eilmi/HAMEG-HM1007-serial-interface/MatLab/HM1007_export-2021_02_25-07_37_34/HM1007_plot-2021_02_25-07_37_34.png

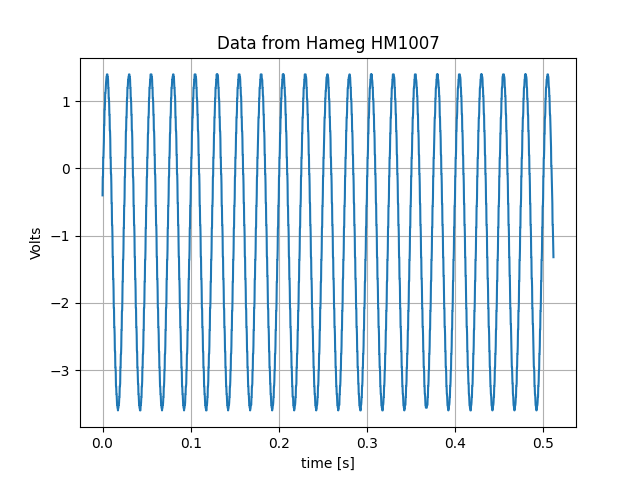
MatLab/HM1007_export-2021_02_25-07_37_34/HM1007_plot-2021_02_25-07_37_34.png
