eilmi/HAMEG-HM1007-serial-interface/Pictures/Hameg_Interface_no_cable.png

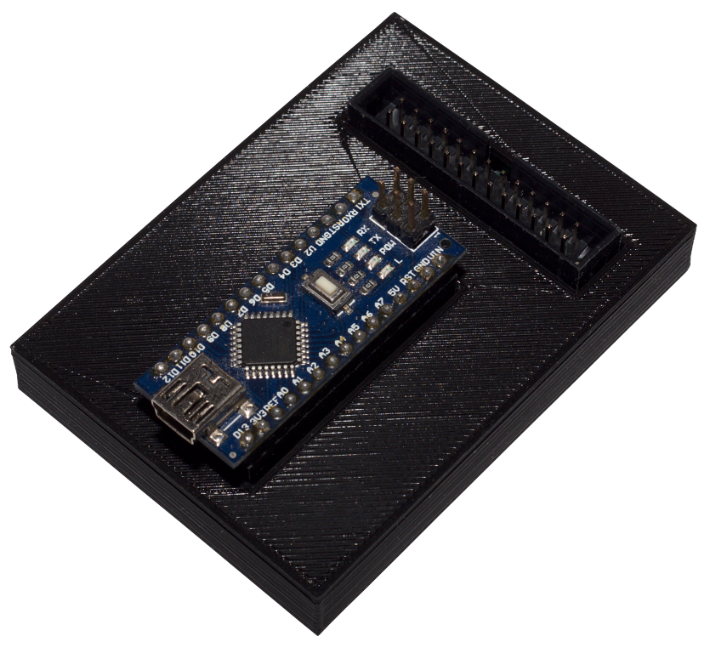
Pictures/Hameg_Interface_no_cable.png
