eilmi/HAMEG-HM1007-serial-interface/Python/testdata/hm1007/4_channels_used/HM1007_data-2022_04_08-07_38_23.csv

time | CH1 | CH2 | REF1 | REF2
0.000000 | 0.320000 | -1.200000 | 0.400000 | -2.200000
0.000000 | 0.400000 | -1.200000 | 0.480000 | -2.200000
0.000000 | 0.400000 | -1.200000 | 0.480000 | -2.200000
0.000001 | 0.400000 | -1.200000 | 0.560000 | -2.200000
0.000001 | 0.400000 | -1.200000 | 0.640000 | -2.000000
0.000001 | 0.480000 | -1.200000 | 0.640000 | -2.000000
0.000002 | 0.480000 | -1.200000 | 0.640000 | -2.000000
0.000002 | 0.560000 | -1.000000 | 0.720000 | -2.000000
0.000002 | 0.560000 | -1.000000 | 0.720000 | -2.000000
0.000002 | 0.560000 | -1.000000 | 0.800000 | -2.000000
0.000002 | 0.560000 | -1.200000 | 0.800000 | -2.000000
0.000003 | 0.640000 | -1.000000 | 0.880000 | -1.800000
0.000003 | 0.640000 | -1.000000 | 0.880000 | -1.800000
0.000003 | 0.640000 | -1.000000 | 0.960000 | -1.800000
0.000003 | 0.640000 | -1.000000 | 0.960000 | -1.800000
0.000004 | 0.720000 | -1.000000 | 0.960000 | -1.800000
0.000004 | 0.720000 | -1.000000 | 1.040000 | -1.800000
0.000004 | 0.720000 | -1.000000 | 1.040000 | -1.800000
0.000005 | 0.720000 | -1.000000 | 1.120000 | -1.800000
0.000005 | 0.800000 | -1.000000 | 1.200000 | -1.600000
0.000005 | 0.800000 | -1.000000 | 1.200000 | -1.600000
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
