eilmi/HAMEG-HM1007-serial-interface/Python/testdata/hm1007/fast_sinus/HM1007_data-2021_02_21-11_49_18.csv

CH1
142
149
149
156
156
159
162
168
168
174
174
176
180
180
181
183
184
185
186
186
187
187
187
186
186
185
182
182
178
178
176
172
172
166
166
163
156
156
150
150
146
139
139
131
131
127
119
119
111
111
107
100
100
93
93
90
84
84
78
78
76
71
71
68
68
66
64
64
63
63
62
63
63
64
64
65
67
67
71
71
72
78
78
83
83
86
92
92
99
99
103
110
110
118
118
122
130
130
138
138
141
149
149
156
156
159
166
166
171
171
174
178
178
182
182
183
185
185
186
186
187
187
187
186
186
185
182
182
178
178
176
172
172
166
166
163
156
156
149
149
146
138
138
131
131
127
119
119
111
111
107
100
100
93
93
90
84
84
78
78
75
72
72
68
68
66
64
64
63
63
62
62
62
64
64
65
67
67
71
71
73
78
78
83
83
86
92
92
100
100
103
110
110
118
118
122
130
130
138
138
142
149
149
156
156
159
165
165
171
171
173
178
178
182
182
183
185
185
187
187
187
187
187
186
186
185
182
182
178
178
176
172
172
166
166
163
157
157
150
150
146
138
138
131
131
127
119
119
111
111
107
100
100
93
93
90
84
84
78
78
75
71
71
68
68
66
64
64
63
63
62
63
63
64
64
65
67
67
71
71
73
77
77
83
83
86
92
92
100
100
103
111
111
118
118
122
130
130
138
138
142
149
149
156
156
159
165
165
171
171
173
178
178
182
182
183
185
185
186
186
187
187
187
186
186
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
