eilmi/HAMEG-HM1007-serial-interface/Python/testdata/hm205-3/hm205-3_both_channels/HM1007_data-2022_05_17-11_46_32.csv

time | CH1 | CH2
0.000000 | 0.160000 | 3.520000
0.000250 | 0.240000 | 3.520000
0.000500 | 0.320000 | 3.520000
0.000750 | 0.400000 | 3.520000
0.001000 | 0.480000 | 3.520000
0.001250 | 0.560000 | 3.520000
0.001500 | 0.640000 | 3.520000
0.001750 | 0.680000 | 3.520000
0.002000 | 0.760000 | 3.520000
0.002250 | 0.800000 | 3.520000
0.002500 | 0.880000 | 3.520000
0.002750 | 0.960000 | 3.520000
0.003000 | 1.040000 | 3.520000
0.003250 | 1.120000 | 3.520000
0.003500 | 1.200000 | 3.520000
0.003750 | 1.280000 | 3.520000
0.004000 | 1.320000 | 3.520000
0.004250 | 1.400000 | 3.520000
0.004500 | 1.480000 | 3.520000
0.004750 | 1.520000 | 3.520000
0.005000 | 1.600000 | 3.520000
0.005250 | 1.640000 | 3.520000
0.005500 | 1.680000 | 3.520000
0.005750 | 1.760000 | 3.520000
0.006000 | 1.840000 | 3.520000
0.006250 | 1.880000 | 3.520000
0.006500 | 1.960000 | 3.520000
0.006750 | 2.000000 | 3.520000
0.007000 | 2.080000 | 3.520000
0.007250 | 2.120000 | 3.520000
0.007500 | 2.160000 | 3.520000
0.007750 | 2.240000 | 3.520000
0.008000 | 2.280000 | 3.520000
0.008250 | 2.320000 | 3.520000
0.008500 | 2.360000 | 3.520000
0.008750 | 2.400000 | 3.520000
0.009000 | 2.440000 | 3.520000
0.009250 | 2.480000 | 3.520000
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
