eilmi/HAMEG-HM1007-serial-interface/Python/testdata/hm205-3/hm205-3_both_CHs_CH2_first/HM1007_data-2022_05_17-11_46_21.csv

time | CH1 | CH2
0.000000 | -0.920000 | 3.520000
0.000250 | -0.920000 | 3.520000
0.000500 | -0.840000 | 3.520000
0.000750 | -0.760000 | 3.520000
0.001000 | -0.680000 | 3.520000
0.001250 | -0.640000 | 3.520000
0.001500 | -0.560000 | 3.520000
0.001750 | -0.480000 | 3.520000
0.002000 | -0.400000 | 3.520000
0.002250 | -0.360000 | 3.520000
0.002500 | -0.280000 | 3.520000
0.002750 | -0.200000 | 3.520000
0.003000 | -0.120000 | 3.520000
0.003250 | -0.040000 | 3.520000
0.003500 | 0.040000 | 3.520000
0.003750 | 0.120000 | 3.520000
0.004000 | 0.160000 | 3.520000
0.004250 | 0.280000 | 3.520000
0.004500 | 0.320000 | 3.520000
0.004750 | 0.400000 | 3.520000
0.005000 | 0.480000 | 3.520000
0.005250 | 0.560000 | 3.520000
0.005500 | 0.640000 | 3.520000
0.005750 | 0.720000 | 3.520000
0.006000 | 0.760000 | 3.520000
0.006250 | 0.840000 | 3.520000
0.006500 | 0.920000 | 3.520000
0.006750 | 0.960000 | 3.520000
0.007000 | 1.040000 | 3.520000
0.007250 | 1.120000 | 3.520000
0.007500 | 1.200000 | 3.520000
0.007750 | 1.280000 | 3.520000
0.008000 | 1.320000 | 3.520000
0.008250 | 1.400000 | 3.520000
0.008500 | 1.480000 | 3.520000
0.008750 | 1.520000 | 3.520000
0.009000 | 1.600000 | 3.520000
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
