eilmi/HAMEG-HM1007-serial-interface/Python/testdata/hm205-3/hm205-3_ch1/HM1007_data-2022_05_17-11_54_51.csv

time | CH1
0.000000 | 0.240000
0.000250 | 0.320000
0.000500 | 0.400000
0.000750 | 0.480000
0.001000 | 0.560000
0.001250 | 0.640000
0.001500 | 0.720000
0.001750 | 0.760000
0.002000 | 0.840000
0.002250 | 0.920000
0.002500 | 1.000000
0.002750 | 1.040000
0.003000 | 1.120000
0.003250 | 1.200000
0.003500 | 1.280000
0.003750 | 1.320000
0.004000 | 1.400000
0.004250 | 1.480000
0.004500 | 1.520000
0.004750 | 1.600000
0.005000 | 1.640000
0.005250 | 1.720000
0.005500 | 1.760000
0.005750 | 1.840000
0.006000 | 1.880000
0.006250 | 1.960000
0.006500 | 2.040000
0.006750 | 2.080000
0.007000 | 2.160000
0.007250 | 2.200000
0.007500 | 2.240000
0.007750 | 2.280000
0.008000 | 2.320000
0.008250 | 2.400000
0.008500 | 2.440000
0.008750 | 2.480000
0.009000 | 2.520000
0.009250 | 2.560000
0.009500 | 2.600000
0.009750 | 2.640000
0.010000 | 2.680000
0.010250 | 2.720000
0.010500 | 2.720000
0.010750 | 2.800000
0.011000 | 2.800000
0.011250 | 2.840000
0.011500 | 2.840000
0.011750 | 2.880000
0.012000 | 2.920000
0.012250 | 2.920000
0.012500 | 2.960000
0.012750 | 2.960000
0.013000 | 2.960000
0.013250 | 3.000000
0.013500 | 3.000000
0.013750 | 3.000000
0.014000 | 3.040000
0.014250 | 3.040000
0.014500 | 3.040000
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
