eilmi/HAMEG-HM1007-serial-interface/Python/testdata/hm205-3/hm205-3_only_CH2/HM1007_data-2022_05_17-11_46_53.csv

time | CH2
0.000000 | 3.520000
0.000250 | 3.520000
0.000500 | 3.520000
0.000750 | 3.520000
0.001000 | 3.520000
0.001250 | 3.520000
0.001500 | 3.520000
0.001750 | 3.520000
0.002000 | 3.520000
0.002250 | 3.520000
0.002500 | 3.520000
0.002750 | 3.520000
0.003000 | 3.520000
0.003250 | 3.520000
0.003500 | 3.520000
0.003750 | 3.520000
0.004000 | 3.520000
0.004250 | 3.520000
0.004500 | 3.520000
0.004750 | 3.520000
0.005000 | 3.520000
0.005250 | 3.520000
0.005500 | 3.520000
0.005750 | 3.520000
0.006000 | 3.520000
0.006250 | 3.520000
0.006500 | 3.520000
0.006750 | 3.520000
0.007000 | 3.520000
0.007250 | 3.520000
0.007500 | 3.520000
0.007750 | 3.520000
0.008000 | 3.520000
0.008250 | 3.520000
0.008500 | 3.520000
0.008750 | 3.520000
0.009000 | 3.520000
0.009250 | 3.520000
0.009500 | 3.520000
0.009750 | 3.520000
0.010000 | 3.520000
0.010250 | 3.520000
0.010500 | 3.520000
0.010750 | 3.520000
0.011000 | 3.520000
0.011250 | 3.520000
0.011500 | 3.520000
0.011750 | 3.520000
0.012000 | 3.520000
0.012250 | 3.520000
0.012500 | 3.520000
0.012750 | 3.520000
0.013000 | 3.520000
0.013250 | 3.520000
0.013500 | 3.520000
0.013750 | 3.520000
0.014000 | 3.520000
0.014250 | 3.520000
0.014500 | 3.520000
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
