eilmi/HAMEG-HM1007-serial-interface/Python/testdata/hm205-3/hm205-3_both_channels/HM1007_plot-2022_05_17-11_46_32.png

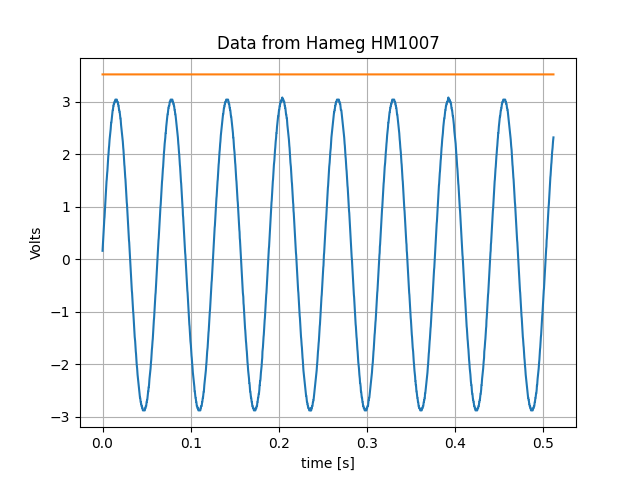
Python/testdata/hm205-3/hm205-3_both_channels/HM1007_plot-2022_05_17-11_46_32.png
