eilmi/HAMEG-HM1007-serial-interface/Python/testdata/hm205-3/hm205-3_both_chs_CH1_first/HM1007_plot-2022_05_17-11_46_19.png

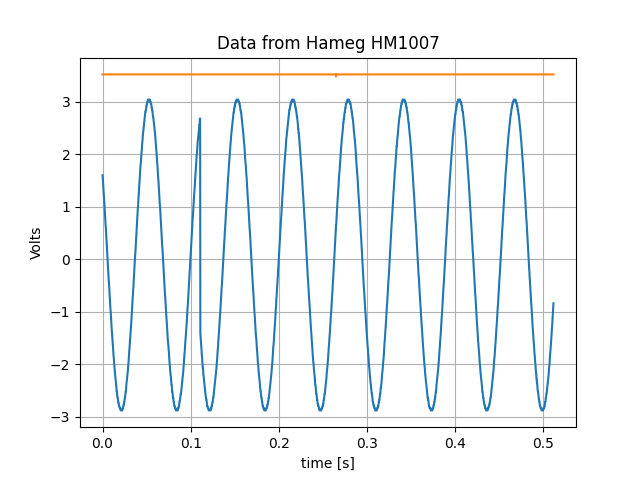
Python/testdata/hm205-3/hm205-3_both_chs_CH1_first/HM1007_plot-2022_05_17-11_46_19.png
