eilmi/HAMEG-HM1007-serial-interface/Python/testdata/hm1007/4_channels_used/HM1007_plot-2022_04_08-07_38_23.png

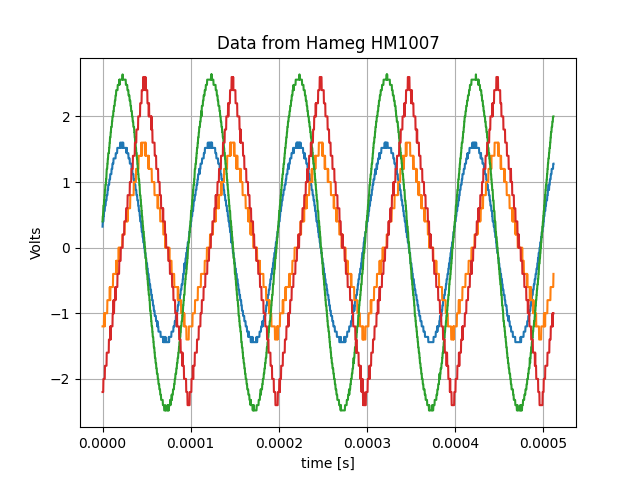
Python/testdata/hm1007/4_channels_used/HM1007_plot-2022_04_08-07_38_23.png
