eilmi/HAMEG-HM1007-serial-interface/Python/testdata/hm1007/rechteck/HM1007_plot-2021_02_21-17_46_05.png

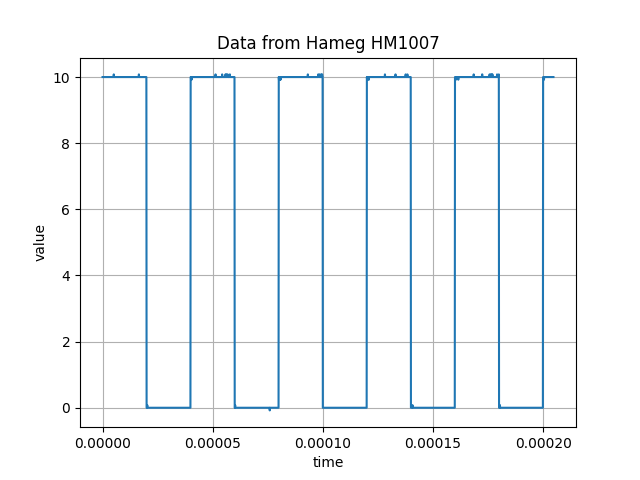
Python/testdata/hm1007/rechteck/HM1007_plot-2021_02_21-17_46_05.png
