eilmi/HAMEG-HM1007-serial-interface/Python/testdata/hm1007/slow_sinus/HM1007_plot-2021_02_21-11_49_03.png

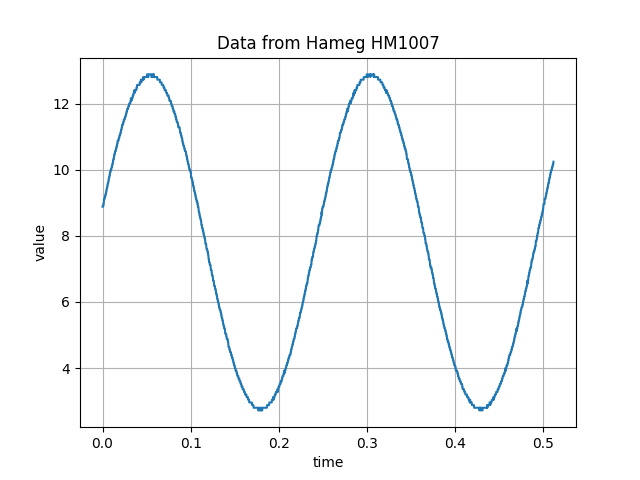
Python/testdata/hm1007/slow_sinus/HM1007_plot-2021_02_21-11_49_03.png
