eilmi/HAMEG-HM1007-serial-interface/(threads)

Thread 2 (2023-03-20):

Mark box connector pin 26 as GND pin.

Nannk, 2023-03-20:
Right now, the pin needs to be deduced from the photo of the wiring job, which can be a bit complicated to read.

Closed 2023-03-21.

Thread 3 (2024-06-25):

AttributeError: module 'scope_gui' has no attribute 'ScopeWindow'

Lovro7a, 2024-06-25:
When I run the program in VS Code, I get this error:

`Traceback (most recent call last):
  File "c:\Users\Lovro\Desktop\hameg_interface\main.py", line 232, in <module>
    main()

  File "c:\Users\Lovro\Desktop\hameg_interface\main.py", line 227, in main
    app = App(root)
          ^^^^^^^^^
  File "c:\Users\Lovro\Desktop\hameg_interface\main.py", line 196, in __init__
    self.scopewindow = scope_gui.ScopeWindow(self)
                       ^^^^^^^^^^^^^^^^^^^^^
AttributeError: module 'scope_gui' has no attribute 'ScopeWindow'
`

How can I fix this?

eilmi, 2024-06-25:
Just tried it on an completely fresh Win11 install and it works after some problems not really related to this project....

Had to install Microsoft Visual C++ redistributable as described in https://kiwisolver.readthedocs.io/en/latest/basis/installation.html

and
pip install msvc-runtime

but after that, it starts without any problems

maybe you could provide a little bit more information?

Lovro7a, 2024-06-25:
I installed Microsoft Visual C++ and the MSVC runtime.

I still get the same error.

In the first picture (error picture 1) is the line of code with the mistake
in main.py.

In the second picture is the class. It is in scope_gui.py.

The third picture shows the folder with the files.

The folder "main" contains the program for Arduino in the Arduino IDE.

The folder "slike" is just a folder with 3 pictures from this email.

I have also tried to copy-paste the name and it didn't work.

When I get this part of the project working, I will make a PCB with the
ATmega328 and FT232 (USB to UART) so I don't need to use the Arduino. If
you want, I can send the Gerber files and schematics to you.

V V tor., 25. jun. 2024 ob 22:40 je oseba Philipp Eilmsteiner <
***@***.***> napisala:

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

Lovro7a, 2024-06-25:
Sorry, I forgot to upload the images to the email I sent you before.

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

eilmi, 2024-06-26:
I'm sorry but this is definitely a problem on your side, because as I already said, it's working on a brand new Win11 install and under Linux without any problems.

Maybe just try cloning the repository again, because your File-Explorer is reporting 0kB file sizes for scope_gui.py, settings_gui.py and signalinfo_gui.py which can't be right.

eilmi, 2024-06-26:
Just download the zip file containing all the files of the repository:

https://github.com/eilmi/HAMEG-HM1007-serial-interface/archive/refs/heads/main.zip

eilmi, 2024-06-28:
closing the issue because there isn't a problem with the project

Closed 2024-06-28.

Thread 4 (2025-02-05):

Which connector/cable to buy

StupdNerd, 2025-02-05:
Hi there, thank you for the interesting development.

I see that you have a ribbon cable and socket to connect to the oscilloscope. Could you please share with me which ones they are or where to get those?

Thank you :)

Nannk, 2025-02-05:
Standart 2.54mm pitch straight header strip socket work fine.
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

eilmi, 2025-02-06:
Hi there!

That's the one I used:

https://www.amazon.de/gp/product/B00TG2J4A0

I think it's a standard 26 pin ribbon cable or "Flachbandkabel" in German ;-)

Feel free to ask if there are any problems with the project !

StupdNerd, 2025-02-07:
Thank you a lot for the kind help. I will have to wait till some parts arrive from China and see if it works.

Closed 2025-02-09.
