eilmi/HAMEG-HM1007-serial-interface/Eagle/Circuit_Board_HM_1007_Interface.sch

## EAGLE design Eagle/Circuit_Board_HM_1007_Interface.sch (2023-03-21)

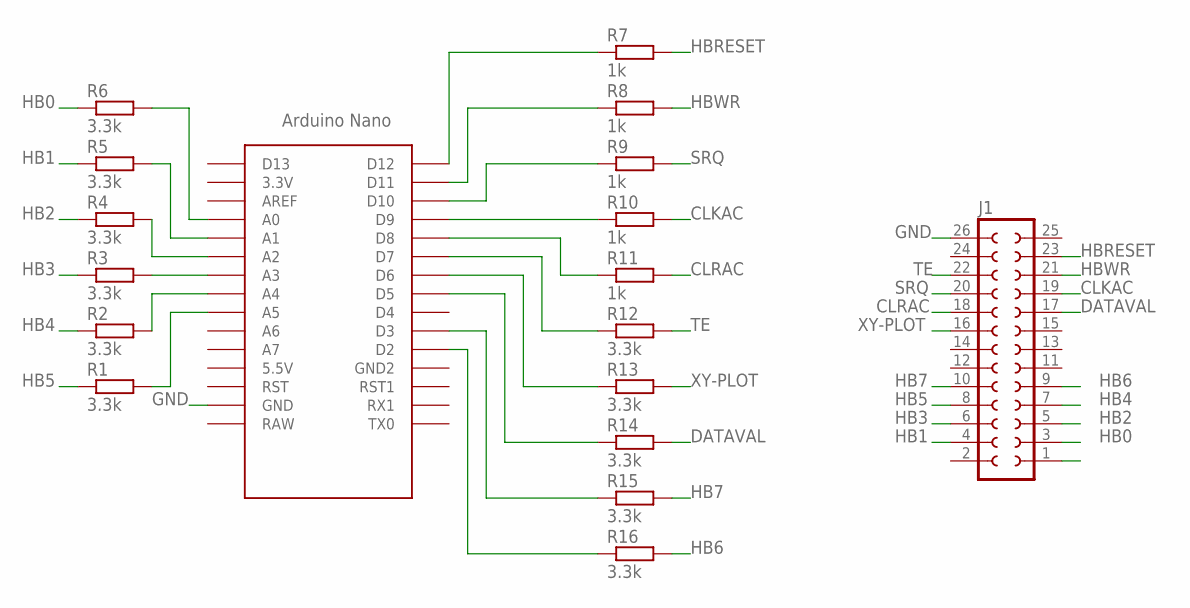
[picture p17: schematic Circuit_Board_HM_1007_Interface.sch]

Parts:
J1: SOCKET-26V; S26V
R1, R2, R3, R4, R5, R6, R12, R13, R14, R15, R16: 3.3k; 0204/7
R7, R8, R9, R10, R11: 1k; 0204/7
U$1: NANO

Connections:
CLKAC: J1.19, R10.2
CLRAC: J1.18, R11.2
DATAVAL: J1.17, R14.2
GND: J1.26, U$1.GND
HB0: J1.3, R6.1
HB1: J1.4, R5.1
HB2: J1.5, R4.1
HB3: J1.6, R3.1
HB4: J1.7, R2.1
HB5: J1.8, R1.1
HB6: J1.9, R16.2
HB7: J1.10, R15.2
HBRESET: J1.23, R7.2
HBWR: J1.21, R8.2
unnamed: R6.2, U$1.A0
unnamed: R5.2, U$1.A1
unnamed: R4.2, U$1.A2
unnamed: R3.2, U$1.A3
unnamed: R2.2, U$1.A4
unnamed: R1.2, U$1.A5
unnamed: R16.1, U$1.D2
unnamed: R15.1, U$1.D3
unnamed: R14.1, U$1.D5
unnamed: R13.1, U$1.D6
unnamed: R12.1, U$1.D7
unnamed: R11.1, U$1.D8
unnamed: R10.1, U$1.D9
unnamed: R7.1, U$1.D12
unnamed: R8.1, U$1.D11
unnamed: R9.1, U$1.D10
SRQ: J1.20, R9.2
TE: J1.22, R12.2
XY-PLOT: J1.16, R13.2
