eilmi/HAMEG-HM1007-serial-interface/(commit log)

2021-01-27 first upload of sourcecode
    [pandas_dataframe.csv]
2021-02-20 started programming GUI version
    [pandas_dataframe.csv]
2021-02-22 reformatted sourcecode switched to pycharm
2021-02-24 file export not working
    [data_export_gui.py, settings_gui.py]
2021-02-24 restructured GUI programming, fixed saving issues
    [data_export_gui.py, scope_gui.py, settings_gui.py]
2021-02-24 fixed read from scope bugs
    [data_export_gui.py]
2021-02-25 fixed wrong fft DC offset minor improvments to GUI
    [data_export_gui.py, scope_gui.py, settings_gui.py]
2021-03-05 fixed scaling of reference channels
    [data_export_gui.py, hameghm1007.py, scope_gui.py]
2021-03-06 added MatLab files and pictures
    [HM1007_data-2021_02_25-07_37_34.csv, HM1007_data-2021_02_25-07_41_05.csv]
2021-03-27 started designing PCB, readme.md updated
    [Circuit_Board_HM_1007_Interface.sch]
2021-07-03 arduino oscilloscope ID check implemented
2022-04-07 switched to main branch for updating readme on github
2022-05-17 added support for hm205-3
    [HM1007_data-2021_02_21-11_49_03.csv, HM1007_data-2021_02_21-11_49_18.csv, HM1007_data-2021_02_21-17_46_05.csv, HM1007_data-2022_04_08-07_38_23.csv, HM1007_data-2022_05_17-11_46_19.csv, HM1007_data-2022_05_17-11_46_21.csv, HM1007_data-2022_05_17-11_46_32.csv, HM1007_data-2022_05_17-11_46_53.csv]
2022-05-17 fixed possible time per division selection for HM205-3
    [hameghm1007.py, main.cpp, main.py, settings_gui.py]
2023-03-21 fixed missing GND label in schematic
    [Circuit_Board_HM_1007_Interface.sch]
